UASTARR/Payload_BIOMEV2/README.md

# Payload_BIOMEV2

## TO-DO
- UART
  - ZE27-O3
- Power Distribution
- Connecting SPI and Power
