UASTARR/Payload_BIOMEV2/PCB_Project/PCB_Project.kicad_pcb

## KiCad design PCB_Project/PCB_Project.kicad_pcb (2024-07-16)

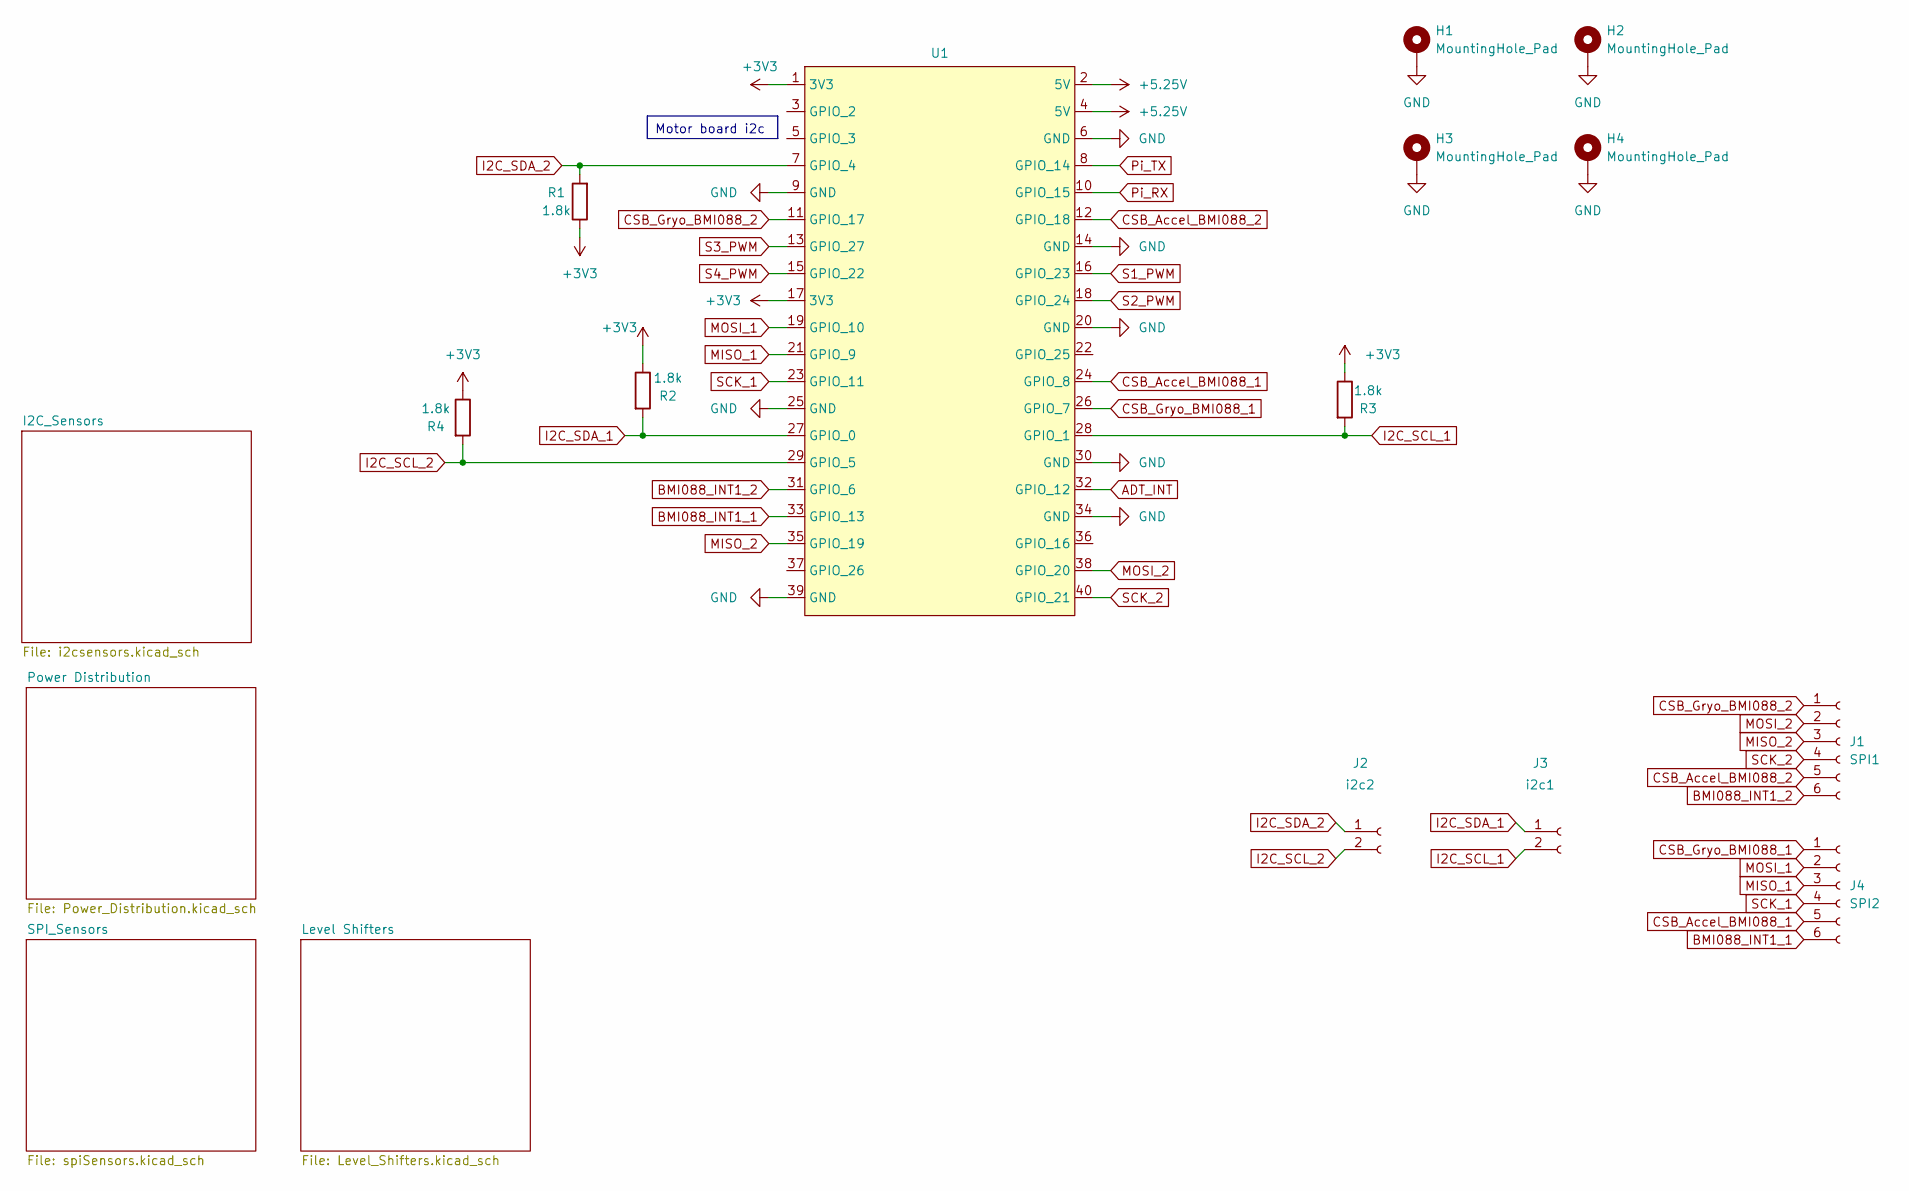
[picture p1: schematic PCB_Project.kicad_sch]

Parts:
H1, H2, H3, H4: MountingHole_Pad; MountingHole_2.5mm_Pad
J1: SPI1; PinHeader_1x06_P2.54mm_Vertical
J2: i2c2; JST_PH_B2B-PH-K_1x02_P2.00mm_Vertical
J3: i2c1; JST_PH_B2B-PH-K_1x02_P2.00mm_Vertical
J4: SPI2; PinHeader_1x06_P2.54mm_Vertical
R1, R2, R3, R4: 1.8k; R_0805_2012Metric
U1: PinSocket_2x20_P2.54mm_Vertical

Connections:
+3V3: R1.1, R2.1, R3.1, R4.1, U1.1 (3V3), U1.17 (3V3); also elsewhere on the board
+5.25V: U1.2 (5V), U1.4 (5V); also elsewhere on the board
ADT_INT: U1.32 (GPIO_12); also elsewhere on the board
BMI088_INT1_1: J4.6, U1.33 (GPIO_13); also elsewhere on the board
BMI088_INT1_2: J1.6, U1.31 (GPIO_6); also elsewhere on the board
CSB_Accel_BMI088_1: J4.5, U1.24 (GPIO_8); also elsewhere on the board
CSB_Accel_BMI088_2: J1.5, U1.12 (GPIO_18); also elsewhere on the board
CSB_Gryo_BMI088_1: J4.1, U1.26 (GPIO_7); also elsewhere on the board
CSB_Gryo_BMI088_2: J1.1, U1.11 (GPIO_17); also elsewhere on the board
GND: H1.1, H2.1, H3.1, H4.1, U1.6 (GND), U1.9 (GND), U1.14 (GND), U1.20 (GND), U1.25 (GND), U1.30 (GND), U1.34 (GND), U1.39 (GND); also elsewhere on the board
I2C_SCL_1: J3.2, R3.2, U1.28 (GPIO_1); also elsewhere on the board
I2C_SCL_2: J2.2, R4.2, U1.29 (GPIO_5); also elsewhere on the board
I2C_SDA_1: J3.1, R2.2, U1.27 (GPIO_0); also elsewhere on the board
I2C_SDA_2: J2.1, R1.2, U1.7 (GPIO_4); also elsewhere on the board
MISO_1: J4.3, U1.21 (GPIO_9); also elsewhere on the board
MISO_2: J1.3, U1.35 (GPIO_19); also elsewhere on the board
MOSI_1: J4.2, U1.19 (GPIO_10); also elsewhere on the board
MOSI_2: J1.2, U1.38 (GPIO_20); also elsewhere on the board
Pi_RX: U1.10 (GPIO_15); also elsewhere on the board
Pi_TX: U1.8 (GPIO_14); also elsewhere on the board
S1_PWM: U1.16 (GPIO_23); also elsewhere on the board
S2_PWM: U1.18 (GPIO_24); also elsewhere on the board
S3_PWM: U1.13 (GPIO_27); also elsewhere on the board
S4_PWM: U1.15 (GPIO_22); also elsewhere on the board
SCK_1: J4.4, U1.23 (GPIO_11); also elsewhere on the board
SCK_2: J1.4, U1.40 (GPIO_21); also elsewhere on the board

Notes on the sheet:
Motor board i2c

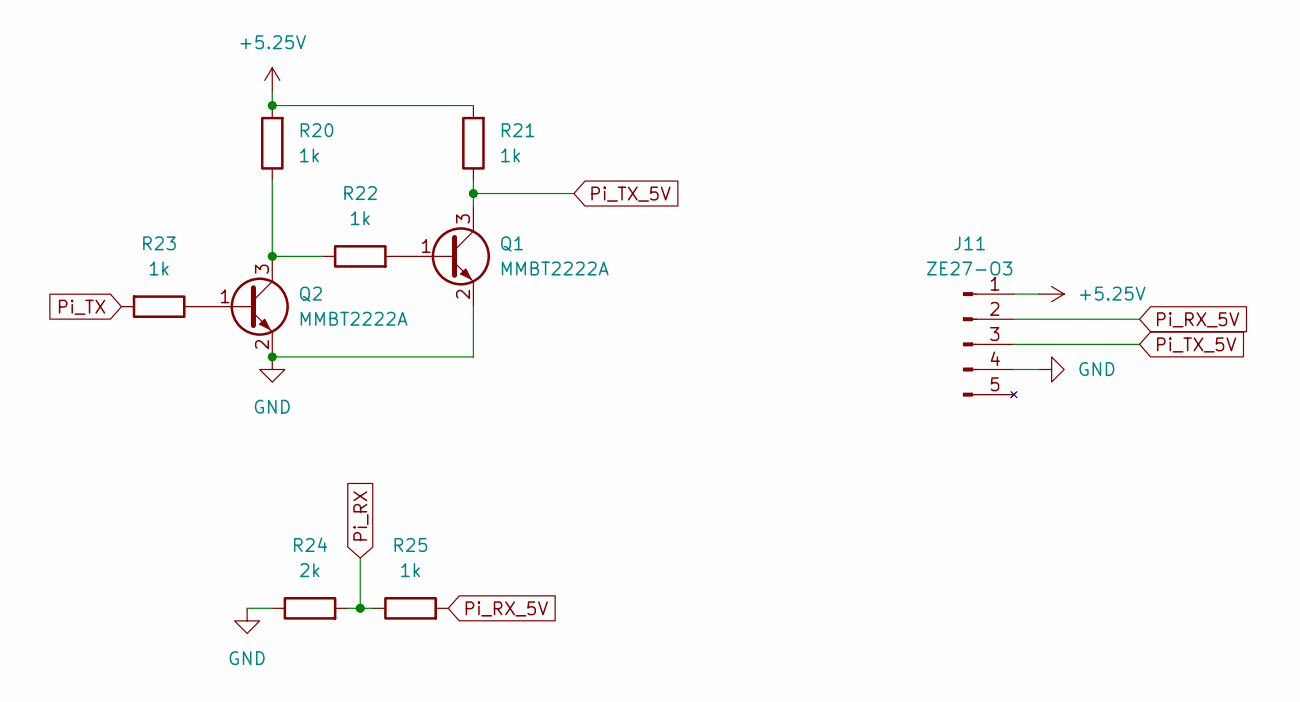
[picture p2: schematic Level_Shifters.kicad_sch]

Parts:
J11: ZE27-O3; PinHeader_1x05_P2.00mm_Vertical
Q1, Q2: MMBT2222A; SOT-23
R20, R21, R22, R23, R25: 1k; R_0402_1005Metric
R24: 2k; R_0402_1005Metric

Connections:
+5.25V: J11.1 (Vin), R20.2, R21.2; also elsewhere on the board
GND: J11.4 (GND), Q1.2 (E), Q2.2 (E), R24.1; also elsewhere on the board
unnamed: Q1.1 (B), R22.2
unnamed: Q2.1 (B), R23.1
unnamed: Q2.3 (C), R20.1, R22.1
Pi_RX: R24.2, R25.1; also elsewhere on the board
Pi_RX_5V: J11.2 (UART_TXD_(Out)), R25.2
Pi_TX: R23.2; also elsewhere on the board
Pi_TX_5V: J11.3 (UART_RX_(In)), Q1.3 (C), R21.1

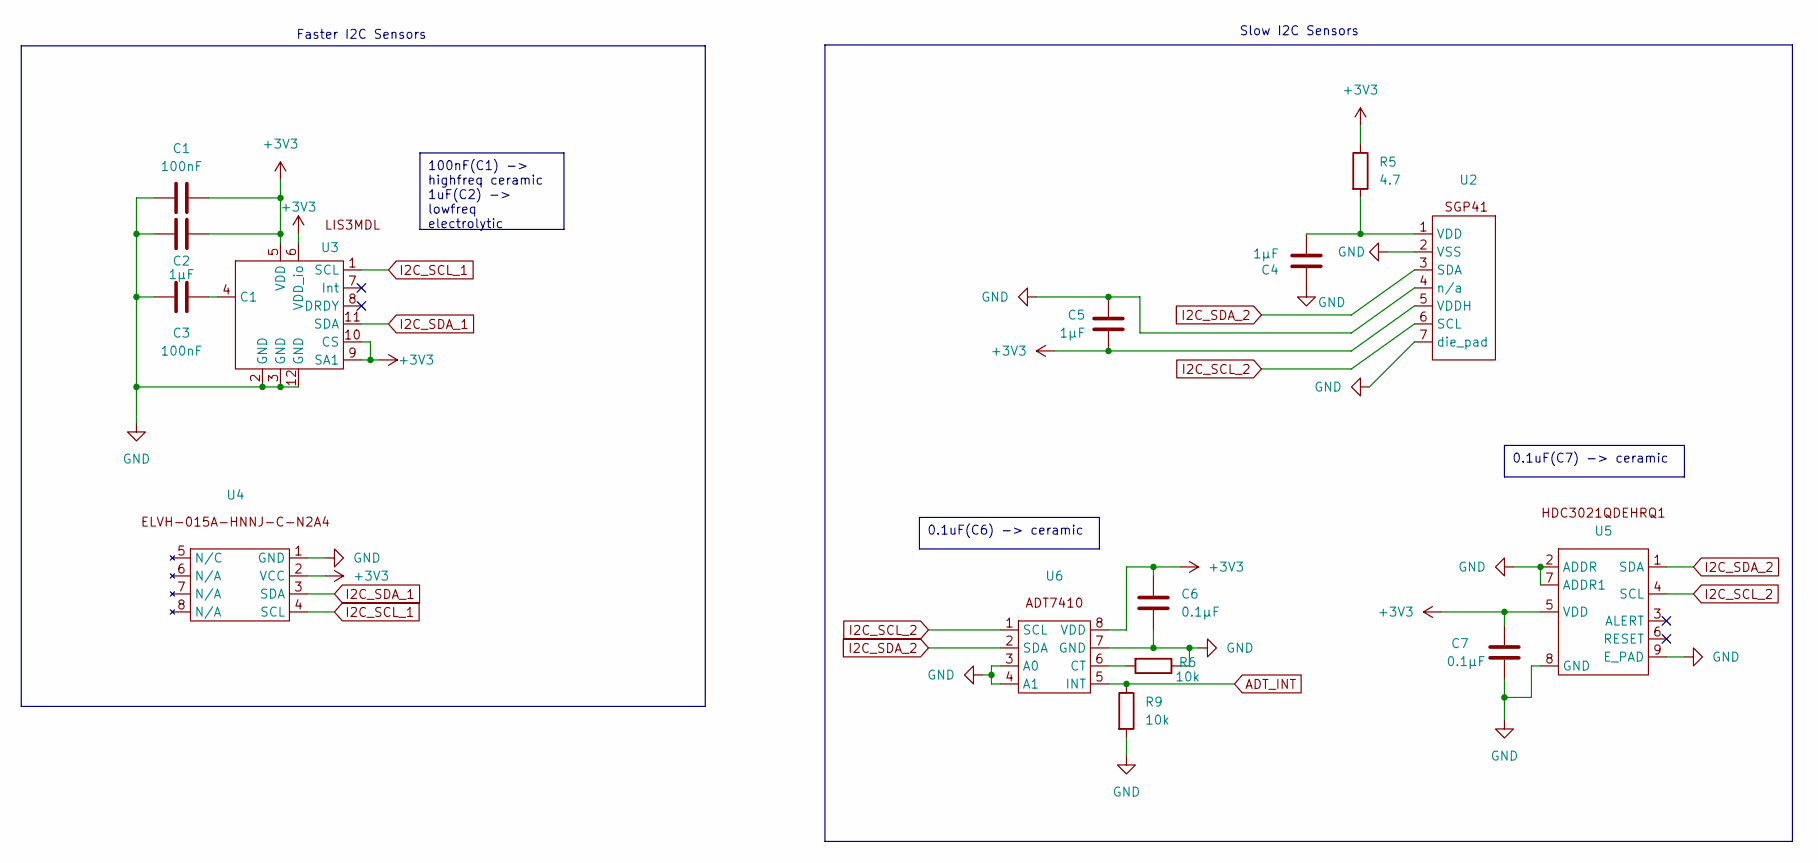
[picture p3: schematic i2csensors.kicad_sch]

Parts:
C1, C3: 100nF; C_0402_1005Metric
C2, C4, C5: 1µF; C_0402_1005Metric
C6, C7: 0.1µF; C_0402_1005Metric
R5: 4.7; R_0603_1608Metric
R6, R9: 10k; R_0402_1005Metric
U2: XDCR_SGP41-D-R4
U3: XDCR_LIS3MDL
U4: HNNJ
U5: WSON8_DEH_TEX
U6: SOIC-8

Connections:
+3V3: C1.1, C2.1, C5.2, C6.1, C7.1, R5.1, U2.5 (VDDH), U3.5 (VDD), U3.6 (VDD_io), U3.9 (SA1), U3.10 (CS), U4.2 (VCC), U5.5 (VDD), U6.8 (VDD); also elsewhere on the board
ADT_INT: R9.1, U6.5 (INT); also elsewhere on the board
GND: C1.2, C2.2, C3.2, C4.2, C5.1, C6.2, C7.2, R6.1, R9.2, U2.2 (VSS), U2.4 (n/a), U2.7 (die_pad), U3.2 (GND), U3.3 (GND), U3.12 (GND), U4.1 (GND), U5.2 (ADDR), U5.7 (ADDR1), U5.8 (GND), U5.9 (E_PAD), U6.3 (A0), U6.4 (A1), U6.7 (GND); also elsewhere on the board
I2C_SCL_1: U3.1 (SCL), U4.4 (SCL); also elsewhere on the board
I2C_SCL_2: U2.6 (SCL), U5.4 (SCL), U6.1 (SCL); also elsewhere on the board
I2C_SDA_1: U3.11 (SDA), U4.3 (SDA); also elsewhere on the board
I2C_SDA_2: U2.3 (SDA), U5.1 (SDA), U6.2 (SDA); also elsewhere on the board
unnamed: C4.1, R5.2, U2.1 (VDD)
unnamed: C3.1, U3.4 (C1)
unnamed: R6.2, U6.6 (CT)

Notes on the sheet:
0.1uF(C7) -> ceramic
0.1uF(C6) -> ceramic
100nF(C1) -> highfreq ceramic 1uF(C2) -> lowfreq electrolytic
Slow I2C Sensors
Faster I2C Sensors

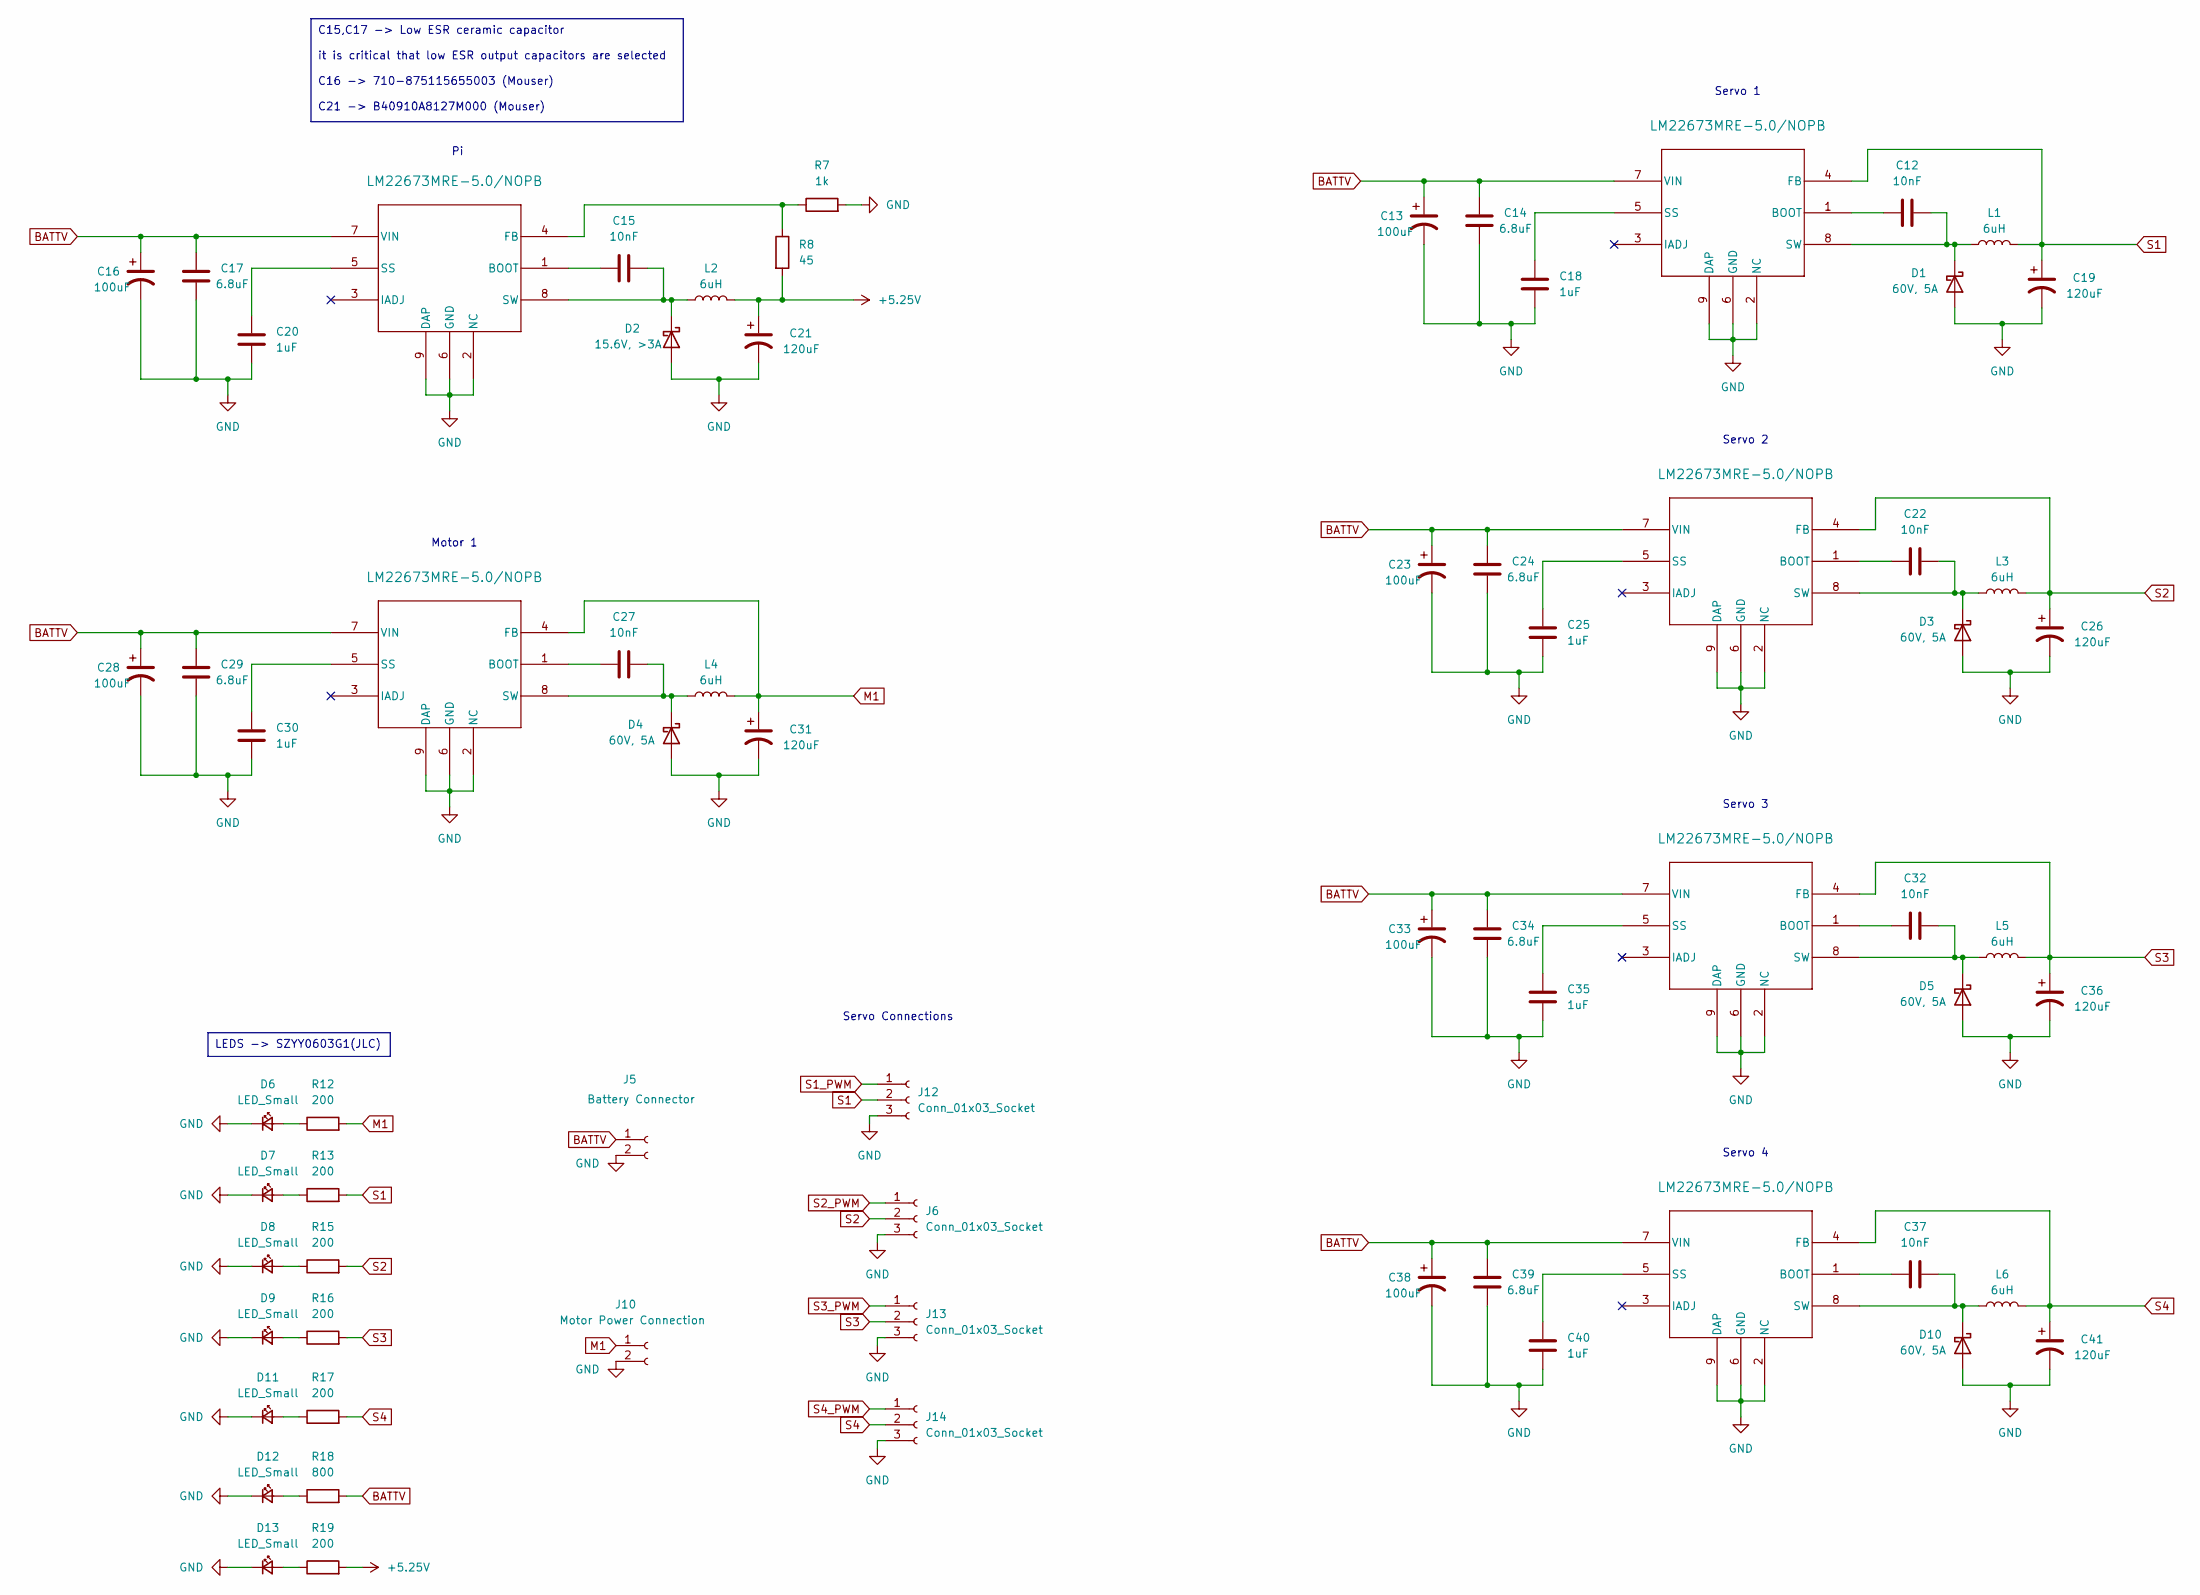
[picture p4: schematic Power_Distribution.kicad_sch]

Parts:
111, 1111, 11111, 11112, 11113, 11114: LM22673MRE-5.0/NOPB; MRA08B
C12, C15, C22, C27, C32, C37: 10nF; C_0603_1608Metric
C13, C16, C23, C28, C33, C38: 100uF; CP_WCAP-PSHP
C14, C17, C24, C29, C34, C39: 6.8uF; C_1206_3216Metric
C18, C20, C25, C30, C35, C40: 1uF; C_0603_1608Metric
C19, C21, C26, C31, C36, C41: 120uF; CP_Elec_10x12.5
D1, D3, D4, D5, D10: 60V, 5A; D_PowerDI-5
D2: 15.6V, >3A; D_PowerDI-5
D6, D7, D8, D9, D11, D12, D13: LED_Small; D_0603_1608Metric
J5: Battery Connector; JST_PH_B2B-PH-K_1x02_P2.00mm_Vertical
J6, J12, J13, J14: Conn_01x03_Socket; JST_PH_B3B-PH-K_1x03_P2.00mm_Vertical
J10: Motor Power Connection; JST_PH_B2B-PH-K_1x02_P2.00mm_Vertical
L1, L2, L3, L4, L5, L6: 6uH; L_6.7x6.7mm
R7: 1k; R_0603_1608Metric
R8: 45; R_0603_1608Metric
R12, R13, R15, R16, R17, R19: 200; R_0402_1005Metric
R18: 800; R_0402_1005Metric

Connections:
+5.25V: C21.1, L2.2, R8.2, R19.2; also elsewhere on the board
BATTV: 111.7 (VIN), 1111.7 (VIN), 11111.7 (VIN), 11112.7 (VIN), 11113.7 (VIN), 11114.7 (VIN), C13.1, C14.1, C16.1, C17.1, C23.1, C24.1, C28.1, C29.1, C33.1, C34.1, C38.1, C39.1, J5.1, R18.2
GND: 111.2 (NC), 111.6 (GND), 111.9 (DAP), 1111.2 (NC), 1111.6 (GND), 1111.9 (DAP), 11111.2 (NC), 11111.6 (GND), 11111.9 (DAP), 11112.2 (NC), 11112.6 (GND), 11112.9 (DAP), 11113.2 (NC), 11113.6 (GND), 11113.9 (DAP), 11114.2 (NC), 11114.6 (GND), 11114.9 (DAP), C13.2, C14.2, C16.2, C17.2, C18.2, C19.2, C20.2, C21.2, C23.2, C24.2, C25.2, C26.2, C28.2, C29.2, C30.2, C31.2, C33.2, C34.2, C35.2, C36.2, C38.2, C39.2, C40.2, C41.2, D1.2 (A), D2.2 (A), D3.2 (A), D4.2 (A), D5.2 (A), D6.1 (K), D7.1 (K), D8.1 (K), D9.1 (K), D10.2 (A), D11.1 (K), D12.1 (K), D13.1 (K), J5.2, J6.3, J10.2, J12.3, J13.3, J14.3, R7.2; also elsewhere on the board
M1: 11112.4 (FB), C31.1, J10.1, L4.2, R12.2
unnamed: 111.1 (BOOT), C15.1
unnamed: 111.4 (FB), R7.1, R8.1
unnamed: 111.5 (SS), C20.1
unnamed: 111.8 (SW), C15.2, D2.1 (K), L2.1
unnamed: 1111.1 (BOOT), C12.1
unnamed: 1111.5 (SS), C18.1
unnamed: 1111.8 (SW), C12.2, D1.1 (K), L1.1
unnamed: 11111.1 (BOOT), C22.1
unnamed: 11111.5 (SS), C25.1
unnamed: 11111.8 (SW), C22.2, D3.1 (K), L3.1
unnamed: 11112.1 (BOOT), C27.1
unnamed: 11112.5 (SS), C30.1
unnamed: 11112.8 (SW), C27.2, D4.1 (K), L4.1
unnamed: 11113.1 (BOOT), C32.1
unnamed: 11113.5 (SS), C35.1
unnamed: 11113.8 (SW), C32.2, D5.1 (K), L5.1
unnamed: 11114.1 (BOOT), C37.1
unnamed: 11114.5 (SS), C40.1
unnamed: 11114.8 (SW), C37.2, D10.1 (K), L6.1
unnamed: D6.2 (A), R12.1
unnamed: D7.2 (A), R13.1
unnamed: D8.2 (A), R15.1
unnamed: D9.2 (A), R16.1
unnamed: D11.2 (A), R17.1
unnamed: D12.2 (A), R18.1
unnamed: D13.2 (A), R19.1
S1: 1111.4 (FB), C19.1, J12.2, L1.2, R13.2
S1_PWM: J12.1; also elsewhere on the board
S2: 11111.4 (FB), C26.1, J6.2, L3.2, R15.2
S2_PWM: J6.1; also elsewhere on the board
S3: 11113.4 (FB), C36.1, J13.2, L5.2, R16.2
S3_PWM: J13.1; also elsewhere on the board
S4: 11114.4 (FB), C41.1, J14.2, L6.2, R17.2
S4_PWM: J14.1; also elsewhere on the board

Notes on the sheet:
LEDS -> SZYY0603G1(JLC)
C15,C17 -> Low ESR ceramic capacitor it is critical that low ESR output capacitors are selected C16 -> 710-875115655003 (Mouser) C21 -> B40910A8127M000 (Mouser)
Servo Connections
Servo 4
Motor 1
Servo 1
Servo 3
Servo 2

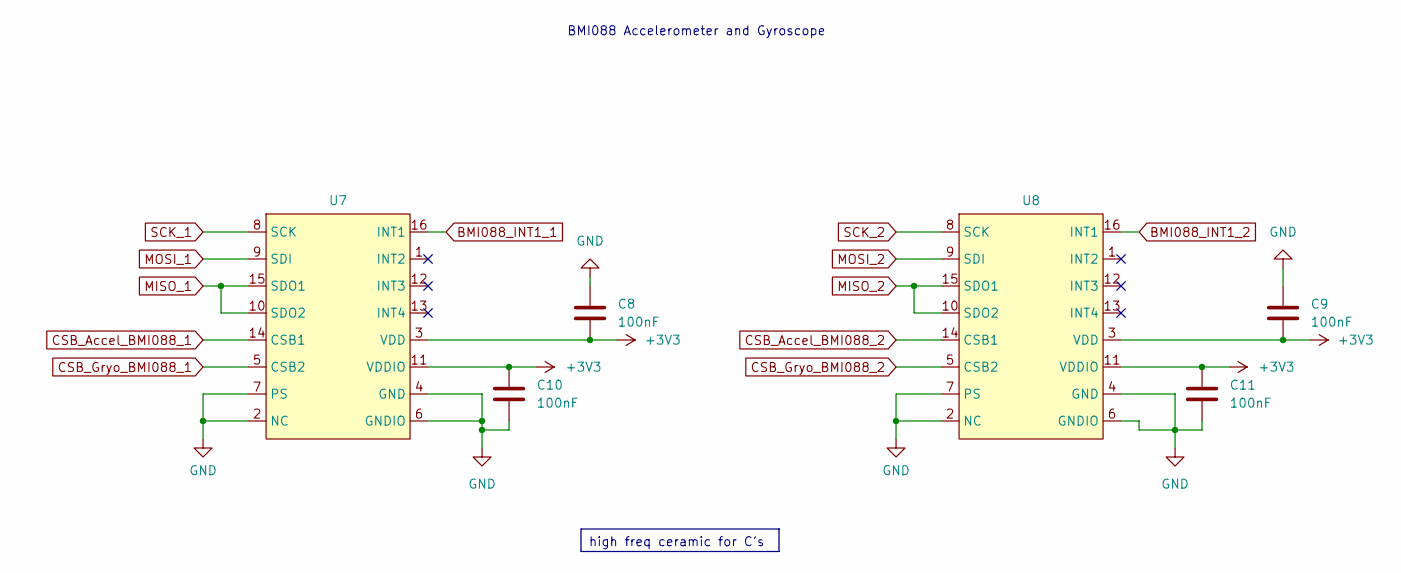
[picture p5: schematic spiSensors.kicad_sch]

Parts:
C8, C9, C10, C11: 100nF; C_0402_1005Metric
U7, U8: PQFN50P450X300X100-16N

Connections:
+3V3: C8.1, C9.1, C10.1, C11.1, U7.3 (VDD), U7.11 (VDDIO), U8.3 (VDD), U8.11 (VDDIO); also elsewhere on the board
BMI088_INT1_1: U7.16 (INT1); also elsewhere on the board
BMI088_INT1_2: U8.16 (INT1); also elsewhere on the board
CSB_Accel_BMI088_1: U7.14 (CSB1); also elsewhere on the board
CSB_Accel_BMI088_2: U8.14 (CSB1); also elsewhere on the board
CSB_Gryo_BMI088_1: U7.5 (CSB2); also elsewhere on the board
CSB_Gryo_BMI088_2: U8.5 (CSB2); also elsewhere on the board
GND: C8.2, C9.2, C10.2, C11.2, U7.2 (NC), U7.4 (GND), U7.6 (GNDIO), U7.7 (PS), U8.2 (NC), U8.4 (GND), U8.6 (GNDIO), U8.7 (PS); also elsewhere on the board
MISO_1: U7.10 (SDO2), U7.15 (SDO1); also elsewhere on the board
MISO_2: U8.10 (SDO2), U8.15 (SDO1); also elsewhere on the board
MOSI_1: U7.9 (SDI); also elsewhere on the board
MOSI_2: U8.9 (SDI); also elsewhere on the board
SCK_1: U7.8 (SCK); also elsewhere on the board
SCK_2: U8.8 (SCK); also elsewhere on the board

Notes on the sheet:
high freq ceramic for C's
BMI088 Accelerometer and Gyroscope

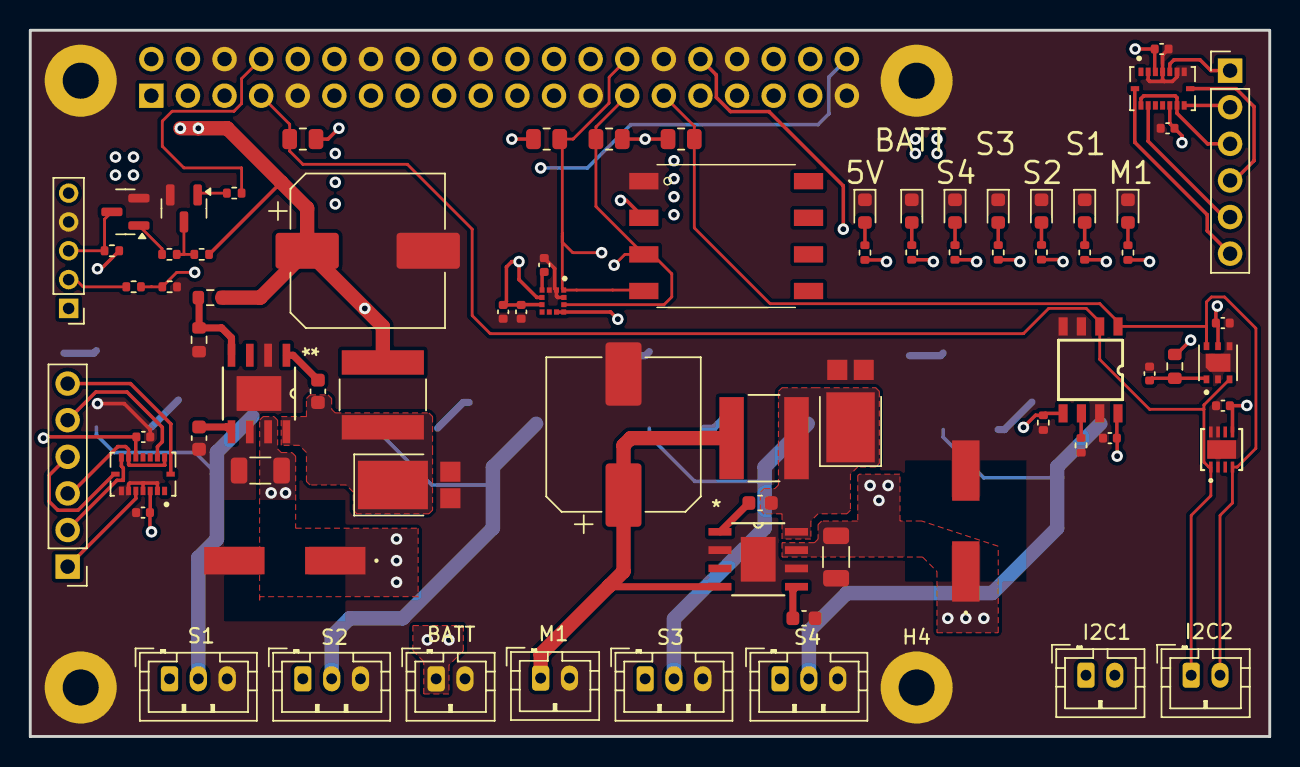
[picture p6: board PCB_Project.kicad_pcb from above]

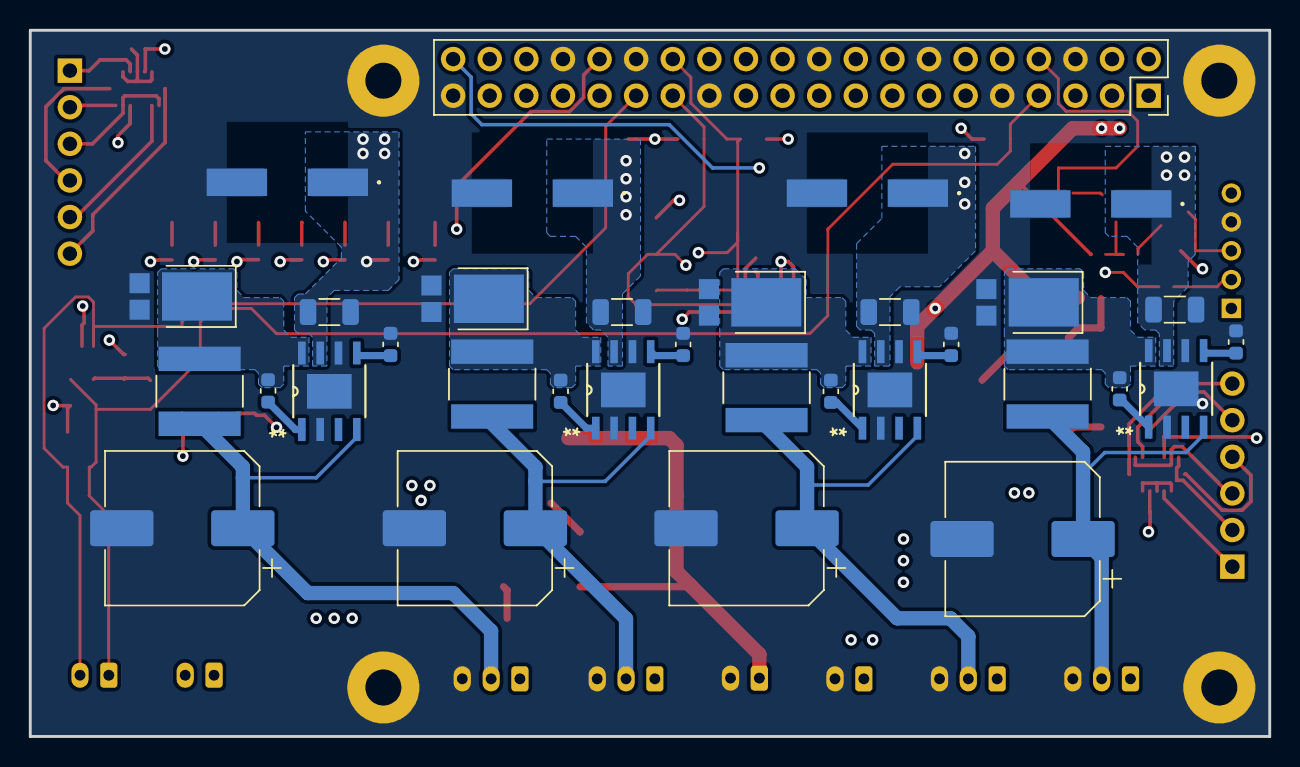
[picture p7: board PCB_Project.kicad_pcb from below]

Board: 4 copper layers, 86.0 x 49.0 mm, 113 parts (33 on the bottom side), 66 nets.
