UASTARR/Payload_BIOMEV2/encoder_protyping_board/encoder_protyping_board.kicad_pcb

## KiCad design encoder_protyping_board/encoder_protyping_board.kicad_pcb (2024-04-02)

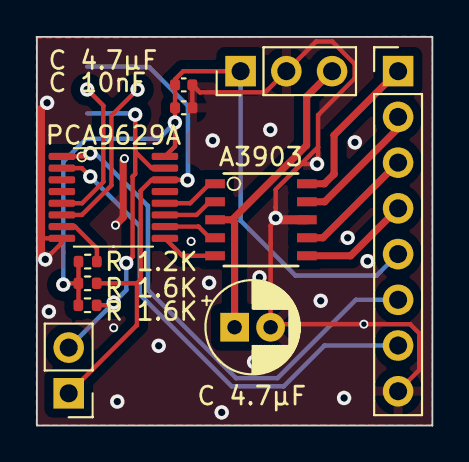
[picture p8: board encoder_protyping_board.kicad_pcb from above]

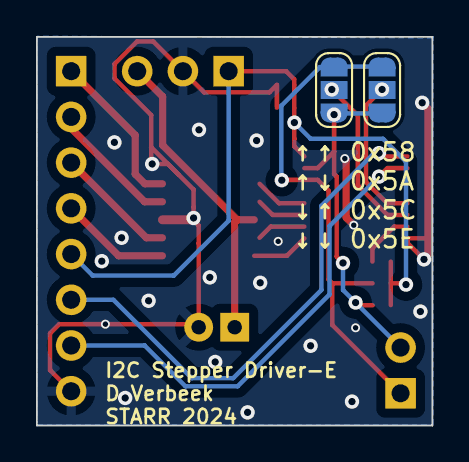
[picture p9: board encoder_protyping_board.kicad_pcb from below]

Board: 2 copper layers, 22.0 x 21.6 mm, 13 parts (2 on the bottom side), 18 nets.

Parts:
A3903: SSOP-10_3.9x4.9mm_P1.00mm
C 4.7µF: 4.7 μF; CP_Radial_D5.0mm_P2.00mm
C 4.7µF#2: 4.7 μF; C_0402_1005Metric
C 10nF: 0.01 μF; C_0402_1005Metric
J1: Conn_02x04_Counter_Clockwise; PinHeader_1x08_P2.54mm_Vertical
J2: Conn_01x02_Pin; PinHeader_1x02_P2.54mm_Vertical
J3: Conn_01x03_Pin; PinHeader_1x03_P2.54mm_Vertical
JP1, JP2: SolderJumper_3_Open; SolderJumper-3_P1.3mm_Open_RoundedPad1.0x1.5mm_NumberLabels
PCA9629A: TSSOP-16_4.4x5mm_P0.65mm
R 1.2K: 1.2k; R_0402_1005Metric
R 1.6K, R 1.6K#2: 1.6k; R_0402_1005Metric

Connections:
+5V: C 4.7µF#2.1, C 10nF.1, J1.5, J3.1, PCA9629A.16 (VDD), R 1.2K.1, R 1.6K.2, R 1.6K#2.1
+12V: A3903.3 (VBB), C 4.7µF.1, J3.3
GND: A3903.8 (GND), C 4.7µF.2, C 4.7µF#2.2, C 10nF.2, J1.8, J3.2, PCA9629A.8 (Vss)
I2C_SCL: J2.1, JP1.3 (B), JP2.1 (A), PCA9629A.14 (SCL), R 1.6K.1
I2C_SDA: J2.2, JP1.1 (A), JP2.3 (B), PCA9629A.15 (SDA), R 1.6K#2.2
unnamed: A3903.10 (OUT1), J1.1
unnamed: A3903.9 (OUT2), J1.2
unnamed: A3903.7 (OUT3), J1.3
unnamed: A3903.6 (OUT4), J1.4
unnamed: J1.6, PCA9629A.1 (P0/DET)
unnamed: J1.7, PCA9629A.2 (P1)
unnamed: JP1.2 (C), PCA9629A.6 (AD1)
unnamed: JP2.2 (C), PCA9629A.5 (AD0)
unnamed: A3903.1 (IN1), PCA9629A.12 (OUT0)
unnamed: A3903.2 (IN2), PCA9629A.11 (OUT1)
unnamed: A3903.4 (IN3), PCA9629A.10 (OUT2)
unnamed: A3903.5 (IN4), PCA9629A.9 (OUT3)
unnamed: PCA9629A.7 (RESET), R 1.2K.2
