UASTARR/Payload_BIOMEV2/encoder_protyping_board_high_current/encoder_protyping_board_high_current.kicad_pcb

## KiCad design encoder_protyping_board_high_current/encoder_protyping_board_high_current.kicad_pcb (2024-05-17)

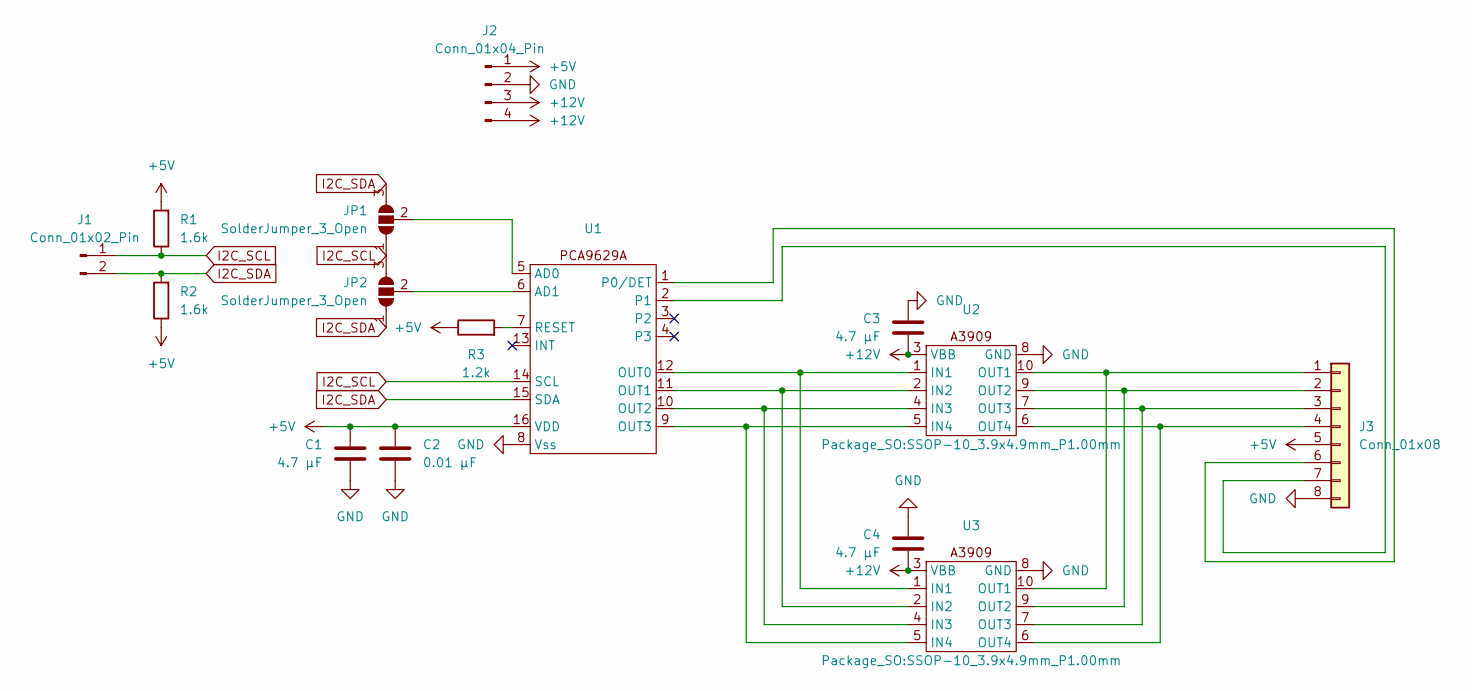
[picture p10: schematic encoder_protyping_board_high_current.kicad_sch]

Parts:
C1: 4.7 μF; C_0402_1005Metric
C2: 0.01 μF; C_0402_1005Metric
C3, C4: 4.7 μF; CP_Radial_D5.0mm_P2.00mm
J1: Conn_01x02_Pin; PinHeader_1x02_P2.54mm_Vertical
J2: Conn_01x04_Pin; PinHeader_1x04_P2.54mm_Vertical
J3: Conn_01x08; PinHeader_1x08_P2.54mm_Vertical
JP1, JP2: SolderJumper_3_Open; SolderJumper-3_P1.3mm_Open_RoundedPad1.0x1.5mm_NumberLabels
R1, R2: 1.6k; R_0402_1005Metric
R3: 1.2k; R_0402_1005Metric
U1: TSSOP-16_4.4x5mm_P0.65mm
U2, U3: SSOP-10_3.9x4.9mm_P1.00mm

Connections:
+5V: C1.1, C2.1, J2.1, J3.5, R1.2, R2.1, R3.1, U1.16 (VDD)
+12V: C3.1, C4.1, J2.3, J2.4, U2.3 (VBB), U3.3 (VBB)
GND: C1.2, C2.2, C3.2, C4.2, J2.2, J3.8, U1.8 (Vss), U2.8 (GND), U3.8 (GND)
I2C_SCL: J1.1, JP1.1 (A), JP2.3 (B), R1.1, U1.14 (SCL)
I2C_SDA: J1.2, JP1.3 (B), JP2.1 (A), R2.2, U1.15 (SDA)
unnamed: J3.1, U2.10 (OUT1), U3.10 (OUT1)
unnamed: J3.2, U2.9 (OUT2), U3.9 (OUT2)
unnamed: J3.3, U2.7 (OUT3), U3.7 (OUT3)
unnamed: J3.4, U2.6 (OUT4), U3.6 (OUT4)
unnamed: J3.6, U1.1 (P0/DET)
unnamed: J3.7, U1.2 (P1)
unnamed: JP1.2 (C), U1.5 (AD0)
unnamed: JP2.2 (C), U1.6 (AD1)
unnamed: U1.12 (OUT0), U2.1 (IN1), U3.1 (IN1)
unnamed: U1.11 (OUT1), U2.2 (IN2), U3.2 (IN2)
unnamed: U1.10 (OUT2), U2.4 (IN3), U3.4 (IN3)
unnamed: U1.9 (OUT3), U2.5 (IN4), U3.5 (IN4)
unnamed: R3.2, U1.7 (RESET)

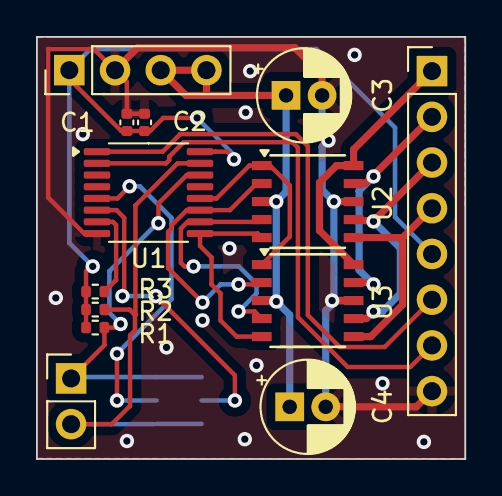
[picture p11: board encoder_protyping_board_high_current.kicad_pcb from above]

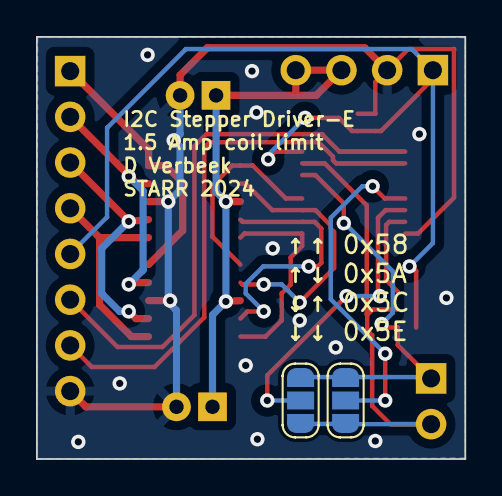
[picture p12: board encoder_protyping_board_high_current.kicad_pcb from below]

Board: 2 copper layers, 23.8 x 23.5 mm, 15 parts (2 on the bottom side), 18 nets.
