UASTARR/Payload_BIOMEV2/(commit log)

2024-02-16 added kicad init project
    [PCB_Project.kicad_pcb, PCB_Project.kicad_sch, dev_board.kicad_sch, i2csensors.kicad_sch, power_management.kicad_sch, spiSensors.kicad_sch]
2024-02-16 added global labels
    [PCB_Project.kicad_sch, i2csensors.kicad_sch, power_management.kicad_sch]
2024-02-23 added barebones SPI sensors
    [spiSensors.kicad_sch]
2024-02-23 added raspberry pi connector
    [PCB_Project.kicad_sch]
2024-02-23 added power board
    [PCB_Project.kicad_sch, power_management.kicad_sch, spiSensors.kicad_sch]
2024-02-23 done for the day work off this now
    [power_management.kicad_sch]
2024-02-25 First 2 i2c sensors
    [i2csensors.kicad_sch]
2024-02-28 LIS3MDL and ELVH-015A-HNNJ-C-N2A4
    bad version of the HDC3021QDEHRQ1 has been removed for now
    [i2csensors.kicad_sch]
2024-02-28 I2C done
    [i2csensors.kicad_sch]
2024-02-28 changed some symbols still going to clean up a bit
    [PCB_Project.kicad_sch, i2csensors.kicad_sch]
2024-02-28 added decumpiling caps
    [PCB_Project.kicad_sch, i2csensors.kicad_sch]
2024-02-28 clean up thx david!
    [PCB_Project.kicad_sch, i2csensors.kicad_sch]
2024-03-05 ADDR1 on the 3021 is not NC
    it should be going to ground
    [PCB_Project.kicad_sch, i2csensors.kicad_sch]
2024-03-07 ADC mostly added
    [spiSensors.kicad_sch]
2024-03-19 motor driver started
    address is 5C
    [PCB_Project.kicad_sch, motor_driver.kicad_sch]
2024-03-19 I2C pullups added
    [i2csensors.kicad_sch, motor_driver.kicad_sch]
2024-03-20 begone ADC you are not needed
    [motor_driver.kicad_sch, spiSensors.kicad_sch]
2024-03-20 added the header
    [motor_driver.kicad_sch]
2024-03-22 encoder schematic
    [encoder_protyping_board.kicad_pcb, encoder_protyping_board.kicad_sch]
2024-03-22 the filter cap does not go between the voltage rail and the input pin
    [encoder_protyping_board.kicad_sch, motor_driver.kicad_sch]
2024-03-22 I have probably done so many things wrong
    [encoder_protyping_board.kicad_pcb, encoder_protyping_board.kicad_sch]
2024-03-23 fixed a trice width and did a bit of rerouting
    0.4mm heading to the motor is all good but does not matter if the 12V power to the chip is not also 0.4mm wide
    [encoder_protyping_board.kicad_pcb]
2024-03-25 more vias on the ground plane and some rerouting
    [encoder_protyping_board.kicad_pcb]
2024-03-25 a better connected ground plane is a happy ground plane
    [encoder_protyping_board.kicad_pcb]
2024-03-25 manual routing is fun
    it is basically a puzzle
    [encoder_protyping_board.kicad_pcb]
2024-03-25 added addresse jumpers
    [encoder_protyping_board.kicad_pcb, encoder_protyping_board.kicad_sch]
2024-03-25 slightly sorter ground path to U1
    [encoder_protyping_board.kicad_pcb]
2024-03-25 added jumper setting on rear silkscreen
    [encoder_protyping_board.kicad_pcb, encoder_protyping_board.kicad_sch]
2024-03-25 Labeled part values
    [encoder_protyping_board.kicad_pcb, encoder_protyping_board.kicad_sch]
2024-03-28 fix my gnd mistake
2024-03-31 lock removed and updated to kicad 8
    [encoder_protyping_board.kicad_pcb, encoder_protyping_board.kicad_sch]
2024-03-31 ignore how ugly it looks I need to fix it
    [PCB_Project.kicad_sch, i2csensors.kicad_sch, motor_driver.kicad_sch, power_management.kicad_sch, spiSensors.kicad_sch]
2024-04-02 working on root sch
    [i2csensors.kicad_sch]
2024-04-02 work baby
    [PCB_Project.kicad_pcb, PCB_Project.kicad_sch, i2csensors.kicad_sch, spiSensors.kicad_sch]
2024-04-02 2 footprints left then can design
    [PCB_Project.kicad_pcb, PCB_Project.kicad_sch, i2csensors.kicad_sch, power_management.kicad_sch, spiSensors.kicad_sch]
2024-04-02 pcb work
    [PCB_Project.kicad_pcb, PCB_Project.kicad_sch, i2csensors.kicad_sch]
2024-04-02 bunch of things
    added to the rear silkscreen
    moved I2C header to edge of board
    rerouted lines so no signals ran around the edge of the board
    beefed up ground to A3903
    made sure ground was around all edges of the board
    cleaned up the 5v runs
    added pin 1 markers for the 2 ICs to front silkscreen
    [encoder_protyping_board.kicad_pcb]
2024-04-04 more cleaning up and adding footprints
    [PCB_Project.kicad_sch, i2csensors.kicad_sch]
2024-04-04 schematic for high current driver
    [encoder_protyping_board_high_current.kicad_pcb, encoder_protyping_board_high_current.kicad_sch]
2024-04-04 high current version done
    [encoder_protyping_board_high_current.kicad_pcb, encoder_protyping_board_high_current.kicad_sch]
2024-04-04 auto clean up on the board
    [encoder_protyping_board_high_current.kicad_pcb]
2024-04-05 pin headers not pin sockets
    [encoder_protyping_board_high_current.kicad_pcb, encoder_protyping_board_high_current.kicad_sch]
2024-05-06 need to fix the one damn footprint
    [PCB_Project.kicad_pcb, PCB_Project.kicad_sch, i2csensors.kicad_sch, spiSensors.kicad_sch]
2024-05-07 pcb init complete
2024-05-07 added gerber files
    [encoder_protyping_board_high_current-B_Cu.gbl, encoder_protyping_board_high_current-B_Mask.gbs, encoder_protyping_board_high_current-B_Paste.gbp, encoder_protyping_board_high_current-B_Silkscreen.gbo, encoder_protyping_board_high_current-Edge_Cuts.gm1, encoder_protyping_board_high_current-F_Cu.gtl, encoder_protyping_board_high_current-F_Mask.gts, encoder_protyping_board_high_current-F_Paste.gtp]
2024-05-07 second gerber files
    [PCB_Project-B_Cu.gbl, PCB_Project-B_Mask.gbs, PCB_Project-B_Paste.gbp, PCB_Project-B_Silkscreen.gbo, PCB_Project-Edge_Cuts.gm1, PCB_Project-F_Cu.gtl, PCB_Project-F_Mask.gts, PCB_Project-F_Paste.gtp]
2024-05-07 re commit
    [PCB_Project.kicad_sch, i2csensors.kicad_sch, spiSensors.kicad_sch]
2024-05-07 everything is now hooked up
    [PCB_Project.kicad_pcb]
2024-05-07 Fixed resistor value for SGP41
    [i2csensors.kicad_sch]
2024-05-07 Swapped Pi_RX and Pi_TX
    [i2csensors.kicad_sch]
2024-05-07 Swapped I2C_SDA_1 and I2C_SCL_1
    [PCB_Project.kicad_sch]
2024-05-07 Rerouted and Cleaned up Board
    [PCB_Project.kicad_pcb]
2024-05-07 added level shifters
    [PCB_Project.kicad_sch, i2csensors.kicad_sch, spiSensors.kicad_sch]
2024-05-08 level shifters added to PCB
    [PCB_Project.kicad_pcb]
2024-05-09 soldering it to the board
    [PCB_Project.kicad_pcb, i2csensors.kicad_sch]
2024-05-11 finaly did that change to make it so this board could run with just a single chip
    [encoder_protyping_board_high_current.kicad_pcb, encoder_protyping_board_high_current.kicad_sch]
2024-05-11 that would have been bad
    changed the outputs to the chips but not the inputs
    [encoder_protyping_board_high_current.kicad_pcb, encoder_protyping_board_high_current.kicad_sch]
2024-05-14 added pos files
    [PCB_Project.kicad_pcb, encoder_protyping_board_high_current.kicad_pcb]
2024-05-17 clean up and better gerbers so jlc doesnt yell at me
    [PCB_Project-B_Cu.gbl, PCB_Project-B_Mask.gbs, PCB_Project-B_Paste.gbp, PCB_Project-B_Silkscreen.gbo, PCB_Project-Edge_Cuts.gm1, PCB_Project-F_Cu.gtl, PCB_Project-F_Mask.gts, PCB_Project-F_Paste.gtp]
2024-05-17 patch antenna is done
    [Patch_Antenna-B_Cu.gbl, Patch_Antenna-B_Mask.gbs, Patch_Antenna-B_Paste.gbp, Patch_Antenna-B_Silkscreen.gbo, Patch_Antenna-Edge_Cuts.gm1, Patch_Antenna-F_Cu.gtl, Patch_Antenna-F_Mask.gts, Patch_Antenna-F_Paste.gtp]
2024-05-17 just a quick cut and paste to move them out
    [encoder_protyping_board.kicad_pcb, encoder_protyping_board.kicad_sch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]
2024-05-17 clean up
    [encoder_protyping_board_high_current-B_Cu.gbl, encoder_protyping_board_high_current-B_Mask.gbs, encoder_protyping_board_high_current-B_Paste.gbp, encoder_protyping_board_high_current-B_Silkscreen.gbo, encoder_protyping_board_high_current-Edge_Cuts.gm1, encoder_protyping_board_high_current-F_Cu.gtl, encoder_protyping_board_high_current-F_Mask.gts, encoder_protyping_board_high_current-F_Paste.gtp]
2024-05-22 don't worry about this Christiaan
    just starting work on a controll program to run on a pi pico to let us controll the board using a CLI interface
2024-05-24 gain to control of when i2c stop happens
    it executes the current state of the registers on an i2c stop event so lets only send one when we want to
2024-05-27 fixed some broken stuff and added the first complex function
    all of this is still untested and next up will be doing some real motor control code
    [main.py]
2024-05-30 working on final board
    [Level_Shifters.kicad_sch, PCB_Project.kicad_pcb, PCB_Project.kicad_sch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]
2024-06-05 power distribution done
    [Level_Shifters.kicad_sch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]
2024-06-06 fixed via's
    [PCB_Project.kicad_pcb, Power Distribution.kicad_pcb]
2024-06-13 added fabs and fixed i2c loop
    [PCB_Project-B_Cu.gbl, PCB_Project-B_Mask.gbs, PCB_Project-B_Paste.gbp, PCB_Project-B_Silkscreen.gbo, PCB_Project-Edge_Cuts.gm1, PCB_Project-F_Cu.gtl, PCB_Project-F_Mask.gts, PCB_Project-F_Paste.gtp]
2024-06-14 removed power board since im simplifing it now
    [Power Distribution.kicad_pcb, Power Distribution.kicad_sch]
2024-06-26 power baby
    [Level_Shifters.kicad_sch, PCB_Project.kicad_pcb, PCB_Project.kicad_sch, Power_Distribution.kicad_sch, i2csensors.kicad_sch, spiSensors.kicad_sch]
2024-06-26 working on pcb
    [Level_Shifters.kicad_sch, PCB_Project.kicad_sch, Power_Distribution.kicad_sch]
2024-07-03 Swapped JST's and fixed FB connections
    [Power_Distribution.kicad_sch]
2024-07-16 Cleaned up wiring, Fixed missing BATTV connection
    [PCB_Project.kicad_pcb]
