UASTARR/Payload_BIOMEV2/(notices)

Notices in the files:
encoder_protyping_board_high_current/micropython_testing_code/main.py:
Copyright (C) 2024 David Verbeek
it under the terms of the GNU General Public License as published by
